Carleton-CTE-Lab/Carleton-Atomic-Force-Microscope/3-D Designs/Active Components/Cantilever Redesigned With 12deg Angle Ver 1.stl

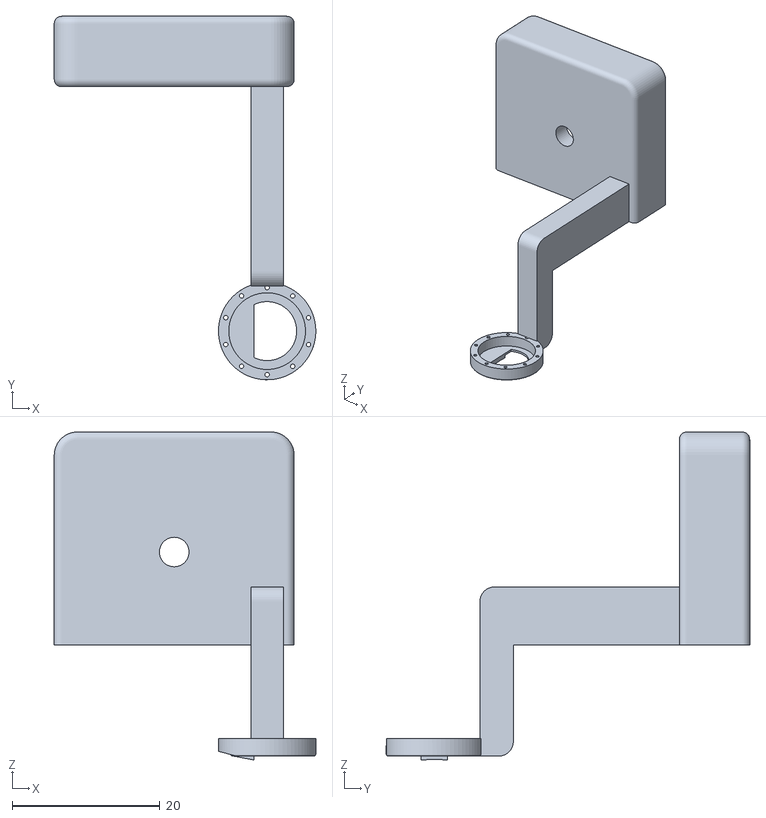
[picture p1: CAD file, 2024-06-18]
3-D Designs/Active Components/Cantilever Redesigned With 12deg Angle Ver 1.stl
35.5 x 49.3 x 44.5
