Carleton-CTE-Lab/Carleton-Atomic-Force-Microscope/3-D Designs/Active Components/Flexi-Holder/Adaption Base.step

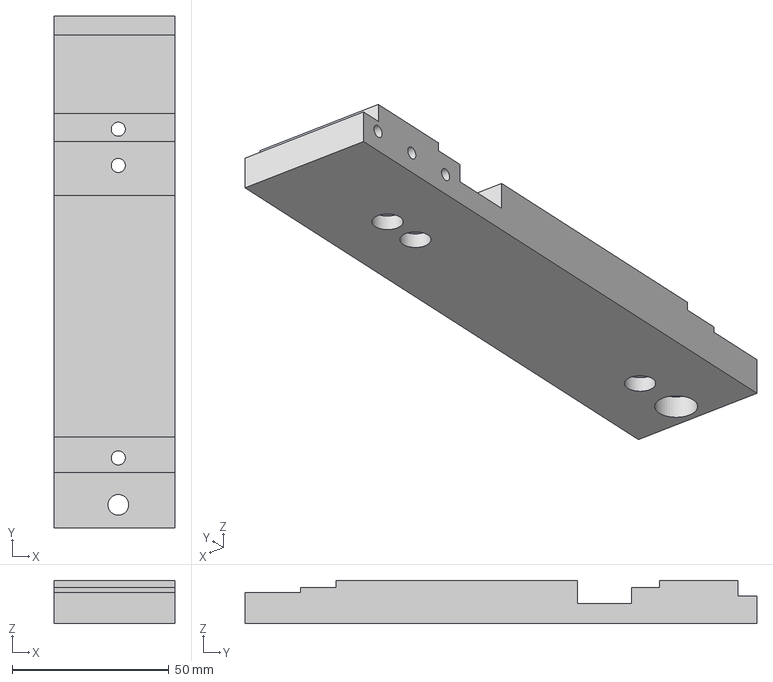
[picture p2: CAD file, 2024-06-18]
3-D Designs/Active Components/Flexi-Holder/Adaption Base.step
38.4 x 163.2 x 13.7 mm
