Carleton-CTE-Lab/Carleton-Atomic-Force-Microscope/3-D Designs/Early Iterations/Cantilever Iterations/Cantilever Holder #8.step

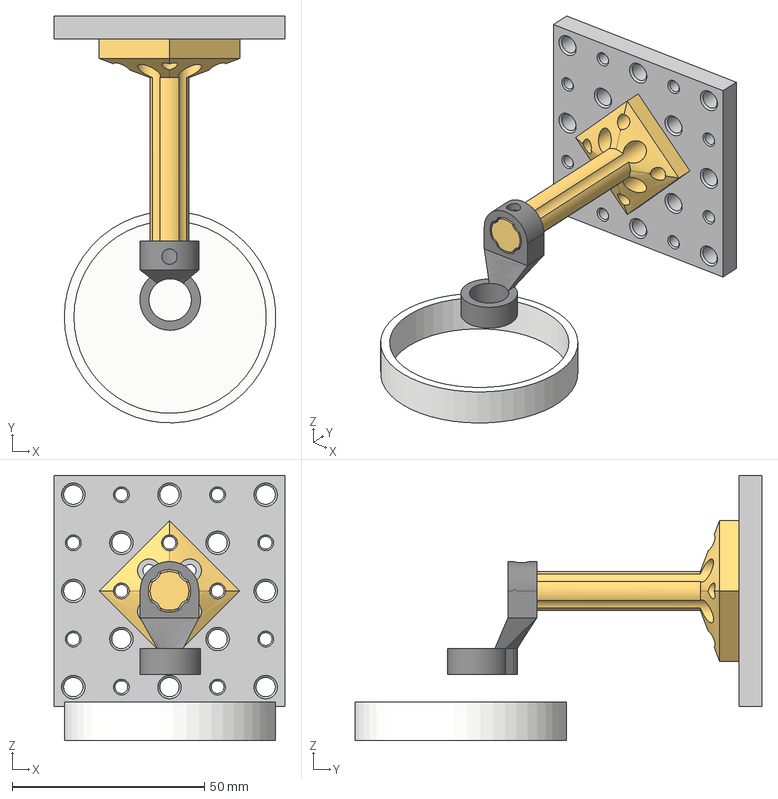
[picture p3: CAD file, 2024-06-24]
3-D Designs/Early Iterations/Cantilever Iterations/Cantilever Holder #8.step
60.0 x 105.7 x 68.9 mm
Petri dish v1
RB13P1_M (Fusion Version)
KB1P_M (Fusion Version)
