Carleton-CTE-Lab/Carleton-Atomic-Force-Microscope/3-D Designs/Early Iterations/Design - Stage Post Clamp - Fixed.step

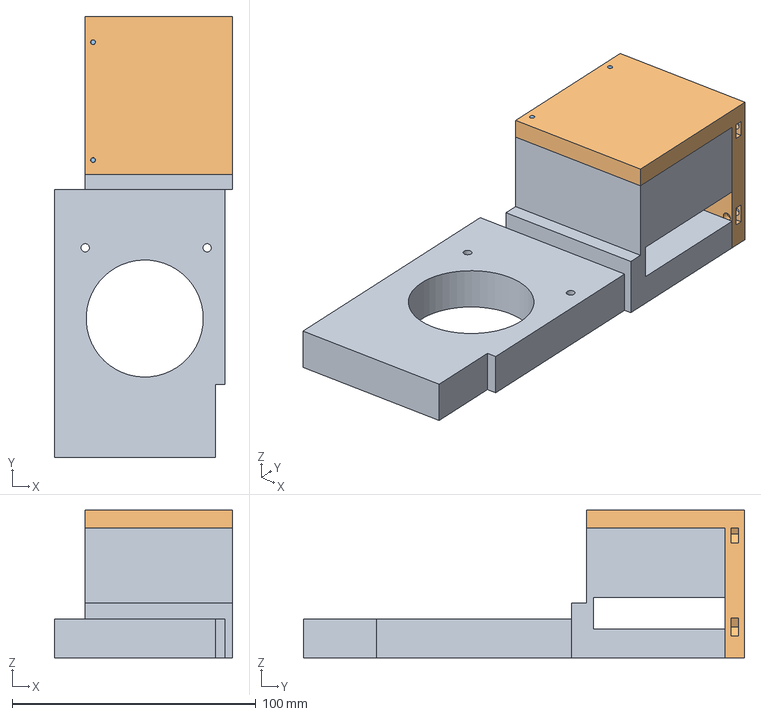
[picture p4: CAD file, 2024-06-24]
3-D Designs/Early Iterations/Design - Stage Post Clamp - Fixed.step
73.0 x 180.9 x 60.6 mm
