Carleton-CTE-Lab/Carleton-Atomic-Force-Microscope/3-D Designs/Early Iterations/Plate Iterations/Plate Renewed Design #16_Plate.step

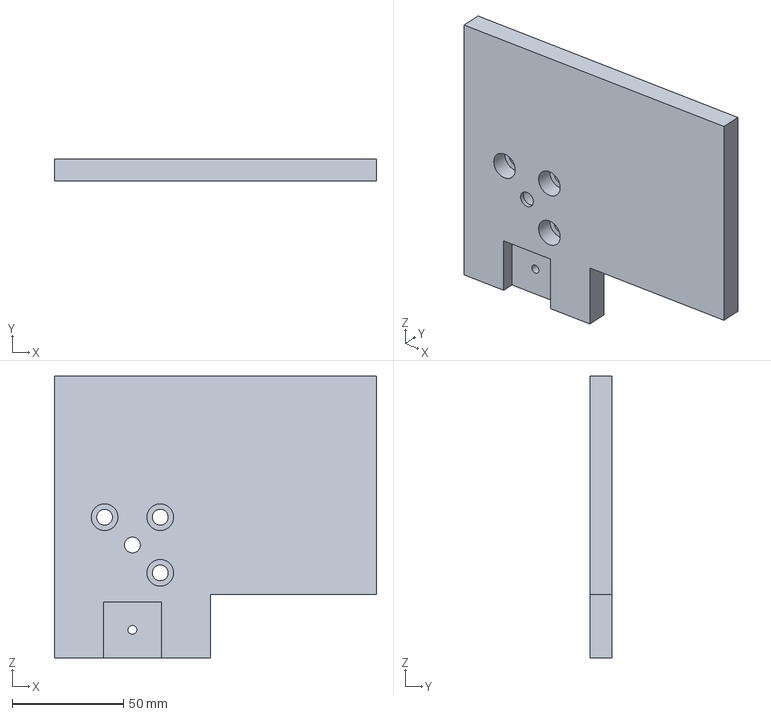
[picture p5: CAD file, 2024-06-24]
3-D Designs/Early Iterations/Plate Iterations/Plate Renewed Design #16_Plate.step
144.6 x 10.0 x 126.6 mm
