Carleton-CTE-Lab/Carleton-Atomic-Force-Microscope/3-D Designs/QOL Accessories/Prism Holder.step

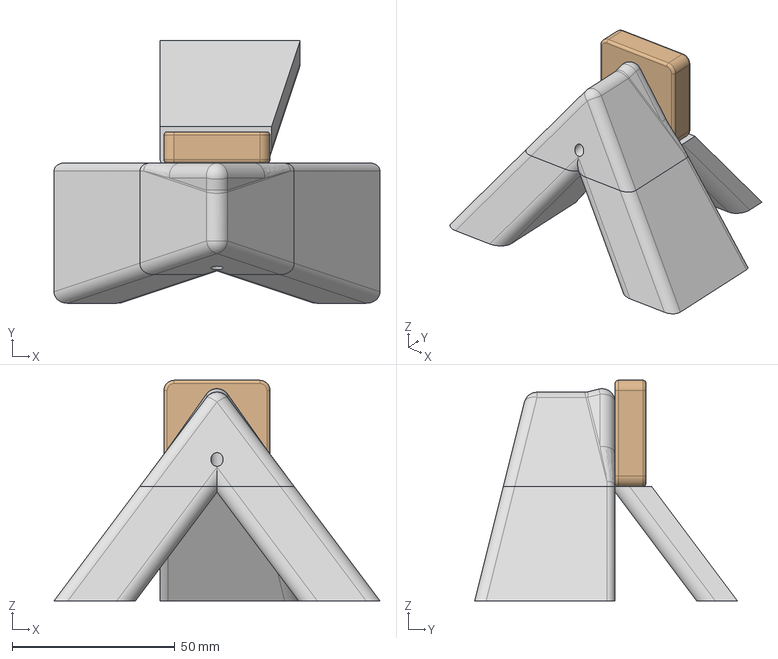
[picture p6: CAD file, 2024-06-18]
3-D Designs/QOL Accessories/Prism Holder.step
100.0 x 80.5 x 67.7 mm
