Carleton-CTE-Lab/Carleton-Atomic-Force-Microscope/3-D Designs/Active Components/Flexi-Holder/Adaption Angle.step

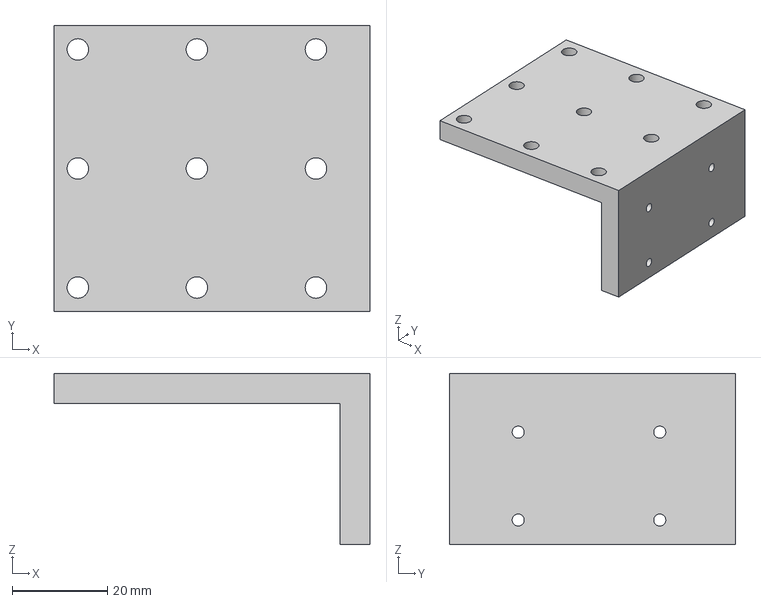
[picture p7: CAD file, 2024-06-18]
3-D Designs/Active Components/Flexi-Holder/Adaption Angle.step
66.4 x 60.0 x 36.0 mm
