Carleton-CTE-Lab/Carleton-Atomic-Force-Microscope/3-D Designs/Early Iterations/Cantilever Iterations/Cxn Base #4 (2nd approach).step

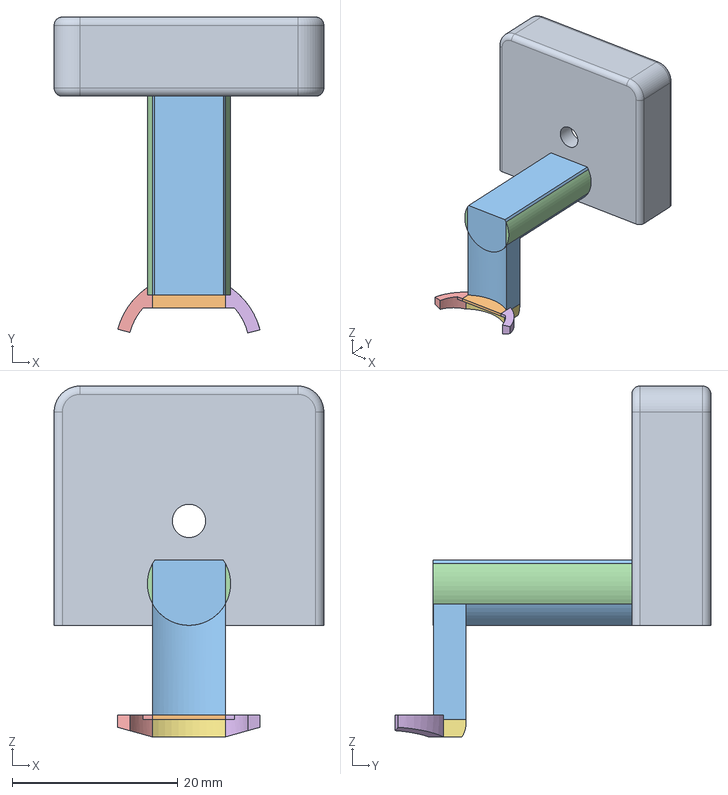
[picture p8: CAD file, 2024-06-24]
3-D Designs/Early Iterations/Cantilever Iterations/Cxn Base #4 (2nd approach).step
32.5 x 38.1 x 42.3 mm
