Carleton-CTE-Lab/Carleton-Atomic-Force-Microscope/3-D Designs/Early Iterations/LED - Driver Adapter.step

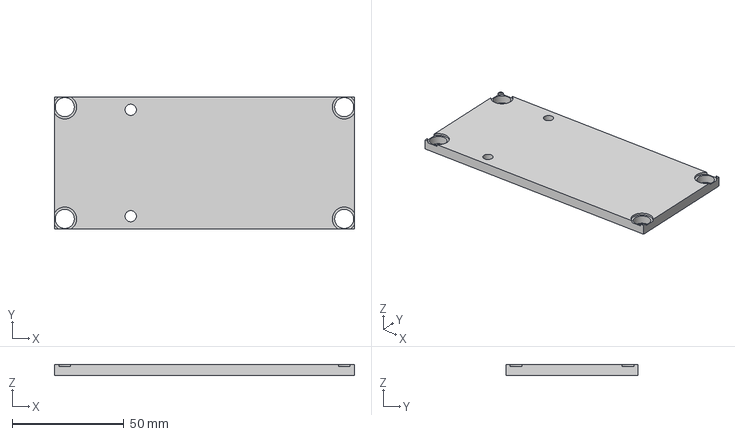
[picture p9: CAD file, 2024-06-24]
3-D Designs/Early Iterations/LED - Driver Adapter.step
134.2 x 59.2 x 5.00 mm
