Carleton-CTE-Lab/Carleton-Atomic-Force-Microscope/3-D Designs/QOL Accessories/AFM Light Fixture.step

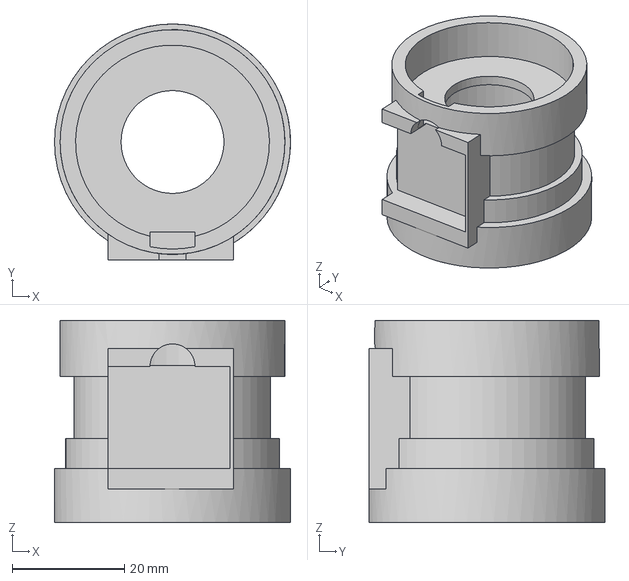
[picture p11: CAD file, 2024-06-18]
3-D Designs/QOL Accessories/AFM Light Fixture.step
42.0 x 42.0 x 36.0 mm
