Carleton-CTE-Lab/Carleton-Atomic-Force-Microscope/3-D Designs/Active Components/Flexi-Holder/Adaption Side.step

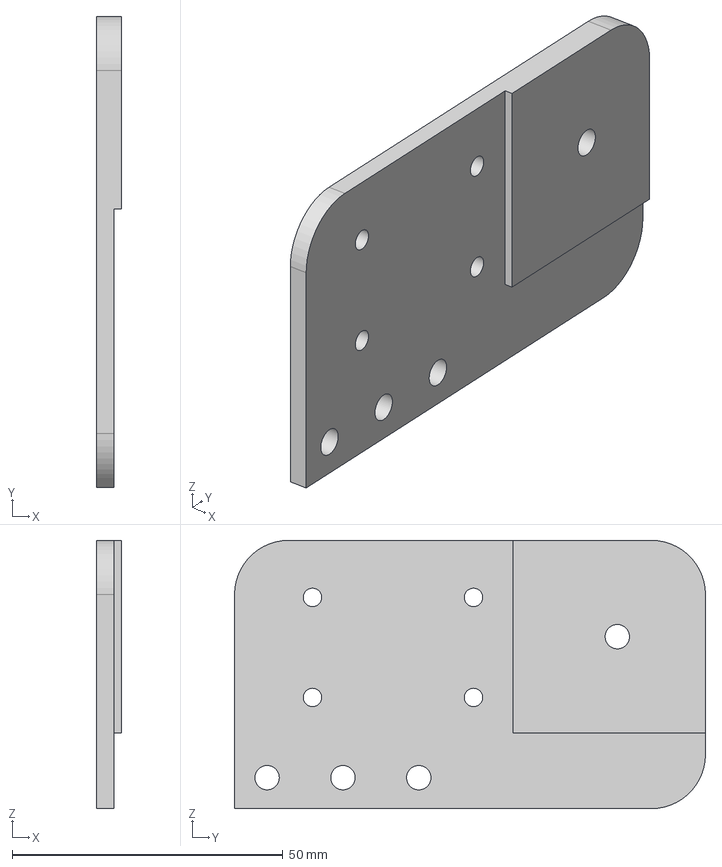
[picture p12: CAD file, 2024-06-18]
3-D Designs/Active Components/Flexi-Holder/Adaption Side.step
4.57 x 87.0 x 49.5 mm
