Carleton-CTE-Lab/Carleton-Atomic-Force-Microscope/3-D Designs/Early Iterations/Cantilever Iterations/Cxn Base #1.step

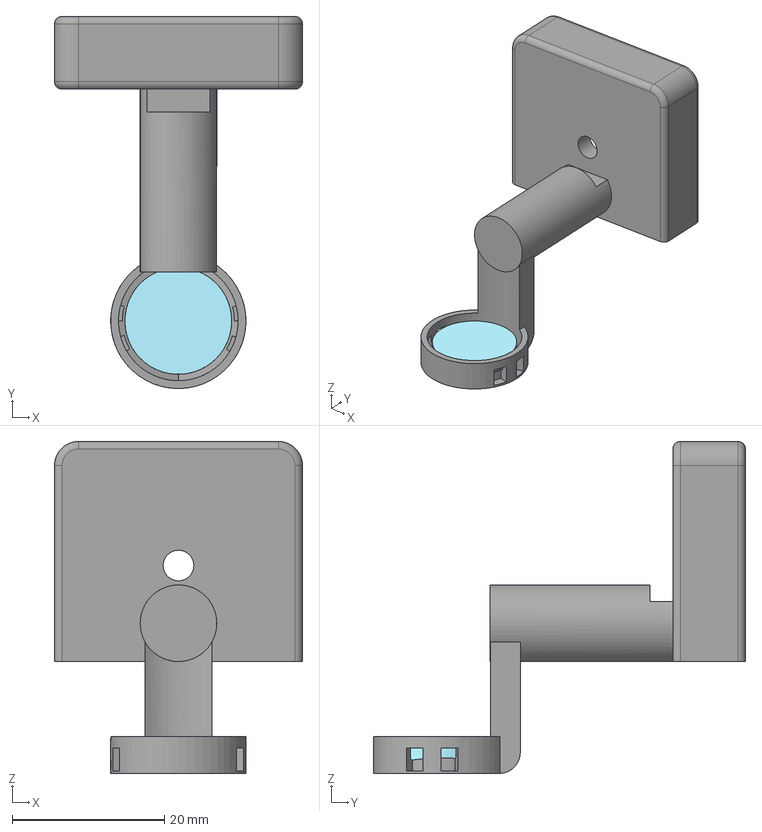
[picture p13: CAD file, 2024-06-24]
3-D Designs/Early Iterations/Cantilever Iterations/Cxn Base #1.step
32.5 x 48.8 x 43.6 mm
