Carleton-CTE-Lab/Carleton-Atomic-Force-Microscope/3-D Designs/Early Iterations/Design - Stage Post Clamp - Adjustable-Removeable.step

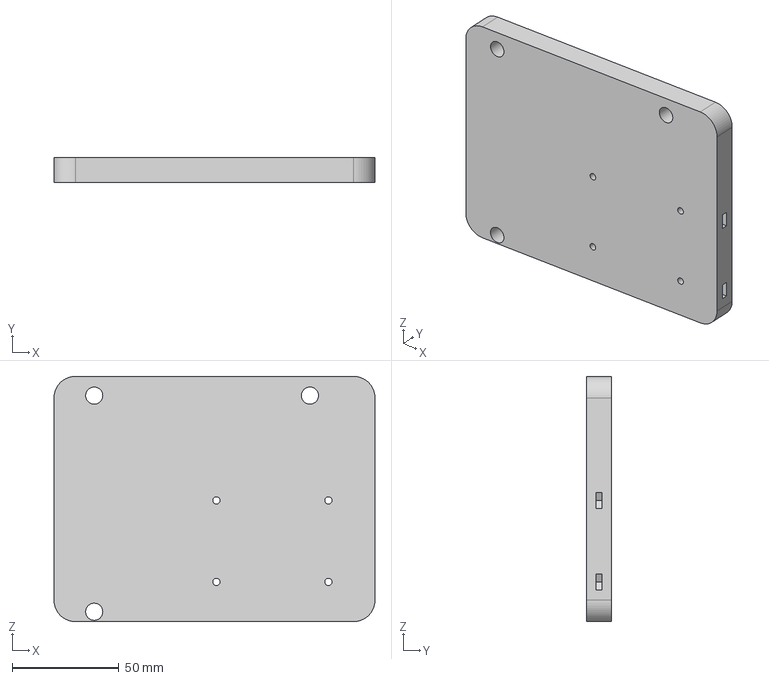
[picture p14: CAD file, 2024-06-24]
3-D Designs/Early Iterations/Design - Stage Post Clamp - Adjustable-Removeable.step
150.0 x 11.6 x 114.6 mm
