Carleton-CTE-Lab/Carleton-Atomic-Force-Microscope/3-D Designs/Early Iterations/Plate Iterations/Plate Renewed Design #8_Plate.step

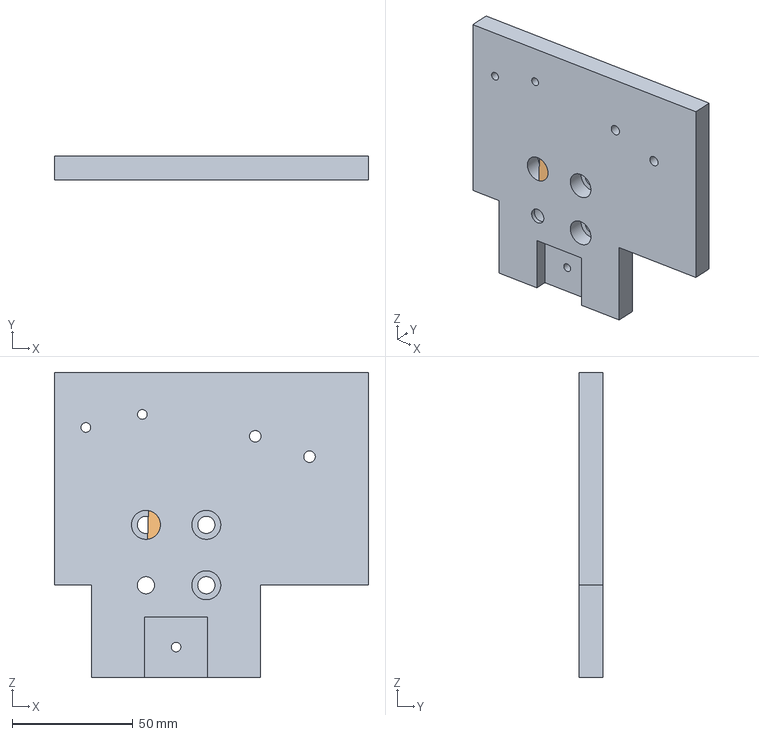
[picture p15: CAD file, 2024-06-24]
3-D Designs/Early Iterations/Plate Iterations/Plate Renewed Design #8_Plate.step
130.0 x 10.0 x 126.3 mm
