Carleton-CTE-Lab/Carleton-Atomic-Force-Microscope/3-D Designs/QOL Accessories/Design - Breadboard Wire Clamp.step

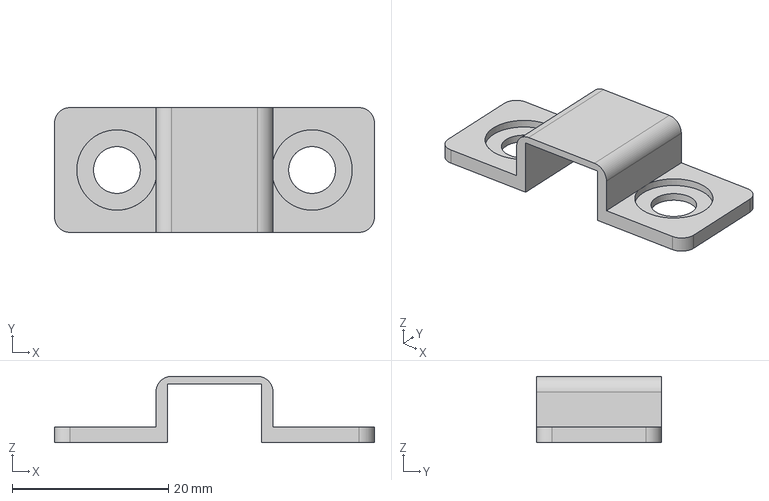
[picture p16: CAD file, 2024-06-18]
3-D Designs/QOL Accessories/Design - Breadboard Wire Clamp.step
41.0 x 16.0 x 8.50 mm
