Carleton-CTE-Lab/Carleton-Atomic-Force-Microscope/3-D Designs/Early Iterations/AFM Flexi Holder.step

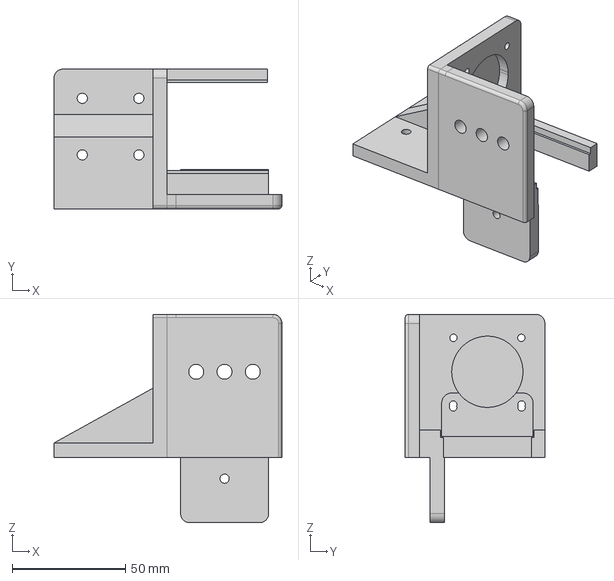
[picture p17: CAD file, 2024-06-24]
3-D Designs/Early Iterations/AFM Flexi Holder.step
100.7 x 61.8 x 92.1 mm
