Carleton-CTE-Lab/Carleton-Atomic-Force-Microscope/3-D Designs/Early Iterations/Cantilever Iterations/Cantilever Holder #12.step

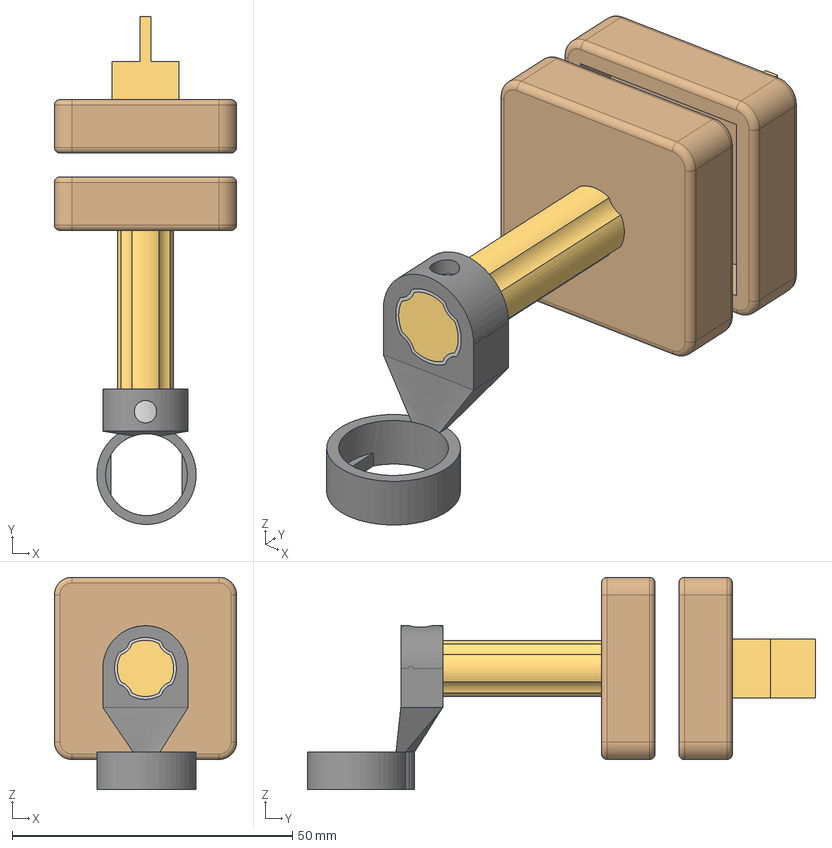
[picture p18: CAD file, 2024-06-24]
3-D Designs/Early Iterations/Cantilever Iterations/Cantilever Holder #12.step
32.5 x 90.7 x 37.9 mm
KB1P_M (Fusion Version) v16
KB25/M(Skin or Cxn Base)_skin(TOP) v1
KB25/M(Skin or Cxn Base)_skin(BOTTOM) v1
