Carleton-CTE-Lab/Carleton-Atomic-Force-Microscope/3-D Designs/QOL Accessories/Design - Breadboard Object Container.step

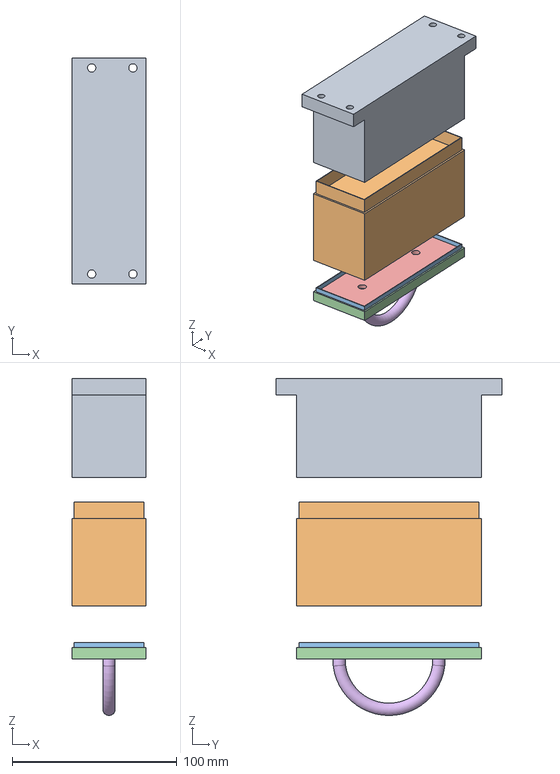
[picture p19: CAD file, 2024-06-18]
3-D Designs/QOL Accessories/Design - Breadboard Object Container.step
45.0 x 137.0 x 204.3 mm
