Carleton-CTE-Lab/Carleton-Atomic-Force-Microscope/3-D Designs/Early Iterations/Cantilever Iterations/Cxn Base Renewed Design #7.step

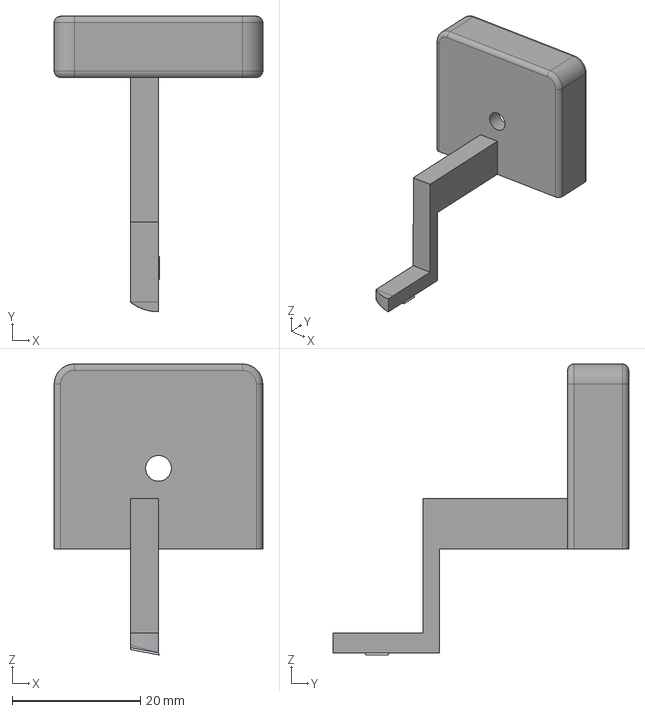
[picture p20: CAD file, 2024-06-24]
3-D Designs/Early Iterations/Cantilever Iterations/Cxn Base Renewed Design #7.step
32.5 x 46.1 x 45.4 mm
Prism (Half) v1(Mirror)
PartCantilever v1
