Carleton-CTE-Lab/Carleton-Atomic-Force-Microscope/3-D Designs/Early Iterations/Cantilever Iterations/Cxn Base Renewed Design #11.step

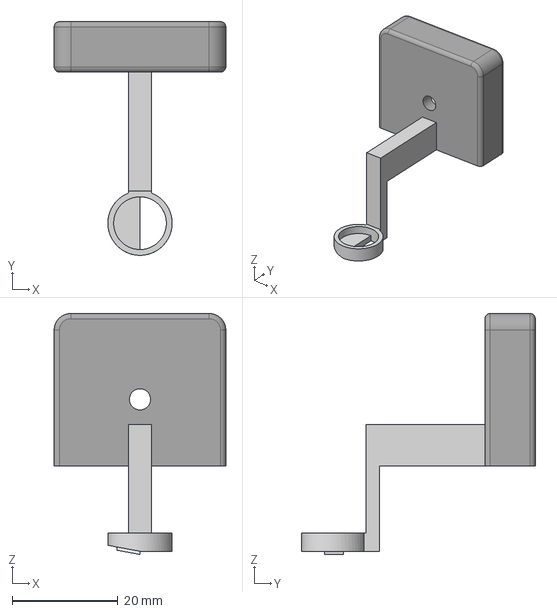
[picture p21: CAD file, 2024-06-24]
3-D Designs/Early Iterations/Cantilever Iterations/Cxn Base Renewed Design #11.step
32.5 x 44.3 x 45.7 mm
