Carleton-CTE-Lab/Carleton-Atomic-Force-Microscope/(list of files, cad)

Other CAD files:
3-D Designs/Active Components/Cantilever Redesigned With 12deg Angle V1.step
3-D Designs/Active Components/Flexi-Holder/Adaption Angle.stl
3-D Designs/Active Components/Flexi-Holder/Adaption Base.stl
3-D Designs/Active Components/Flexi-Holder/Adaption Side.stl
3-D Designs/Early Iterations/AFM Flexi Holder.stl
3-D Designs/Early Iterations/Cantilever Iterations/Cantilever Holder #12.stl
3-D Designs/Early Iterations/Cantilever Iterations/Cantilever Holder #8.stl
3-D Designs/Early Iterations/Cantilever Iterations/Cxn Base #1.stl
3-D Designs/Early Iterations/Cantilever Iterations/Cxn Base #4 (2nd approach).stl
3-D Designs/Early Iterations/Cantilever Iterations/Cxn Base Renewed Design #11.stl
3-D Designs/Early Iterations/Cantilever Iterations/Cxn Base Renewed Design #7.stl
3-D Designs/Early Iterations/Design - Stage Post Clamp - Adjustable-Removeable.stl
3-D Designs/Early Iterations/Design - Stage Post Clamp - Fixed.stl
3-D Designs/Early Iterations/LED - Driver Adapter.stl
3-D Designs/Early Iterations/Plate Iterations/Plate Renewed Design #15_Plate.stl
3-D Designs/Early Iterations/Plate Iterations/Plate Renewed Design #16_Plate.stl
3-D Designs/Early Iterations/Plate Iterations/Plate Renewed Design #8_Plate.stl
3-D Designs/Early Iterations/Version 1/Adapter Concept #2 (AP90 M &PartM0093).step
3-D Designs/Early Iterations/Version 1/Adapter Concept #2 (AP90 M &PartM0093).stl
3-D Designs/Early Iterations/Version 1/Adapter Concept #3 (AP90 M &PartM0093).step
3-D Designs/Early Iterations/Version 1/Adapter Concept #3 (AP90 M &PartM0093).stl
3-D Designs/Early Iterations/Version 1/Adapter Concept #3 (AP90 M &PartM0093)_Component5.step
3-D Designs/Early Iterations/Version 1/Adapter Concept #3 (AP90 M &PartM0093)_Component5.stl
3-D Designs/Early Iterations/Version 1/Adapter Concept #4 (AP90 M &PartM0093).step
3-D Designs/Early Iterations/Version 1/Adapter Concept #4 (AP90 M &PartM0093).stl
3-D Designs/Early Iterations/Version 1/Adapter Concept #4_Component.step
3-D Designs/Early Iterations/Version 1/Adapter Concept #4_Component.stl
3-D Designs/Early Iterations/Version 1/Adapter Concept (AP90_M &PartM0093).step
3-D Designs/Early Iterations/Version 1/Adapter Concept (AP90_M &PartM0093).stl
3-D Designs/Early Iterations/Version 1/Adapter Plate (Feb iteration).step
3-D Designs/Early Iterations/Version 1/Adapter Plate (Feb iteration).stl
3-D Designs/Early Iterations/Version 1/Plate (Background Screen Modification)_MSC2 Modified.step
3-D Designs/Early Iterations/Version 1/Plate (Background Screen Modification)_MSC2 Modified.stl
3-D Designs/Early Iterations/Version 2/Optics Adapter Prototype #1 (RB13P1M & Optics).step
3-D Designs/Early Iterations/Version 2/Optics Adapter Prototype #1 (RB13P1M & Optics).stl
3-D Designs/Early Iterations/Version 2/Optics Adapter Prototype #2 (RB13P1M & Optics).step
3-D Designs/Early Iterations/Version 2/Optics Adapter Prototype #2 (RB13P1M & Optics).stl
3-D Designs/Early Iterations/Version 2/Optics Adapter Prototype #3 (RB13P1M & Optics).step
3-D Designs/Early Iterations/Version 2/Optics Adapter Prototype #3 (RB13P1M & Optics).stl
3-D Designs/Early Iterations/Version 2/Optics Adapter Prototype #4 (RB13P1M & Optics).step
3-D Designs/Early Iterations/Version 2/Optics Adapter Prototype #4 (RB13P1M & Optics).stl
3-D Designs/Early Iterations/Version 2/Optics Adapter Prototype #5 (RB13P1M & Optics).step
3-D Designs/Early Iterations/Version 2/Optics Adapter Prototype #5 (RB13P1M & Optics).stl
3-D Designs/Early Iterations/Version 2/Optics Adapter Prototype #6 (RB13P1M & Optics).step
3-D Designs/Early Iterations/Version 2/Optics Adapter Prototype #6 (RB13P1M & Optics).stl
3-D Designs/Early Iterations/Version 2/Optics Adapter Prototype #7 (RB13P1M & Optics).step
3-D Designs/Early Iterations/Version 2/Optics Adapter Prototype #7 (RB13P1M & Optics).stl
3-D Designs/Early Iterations/Version 2/Plate #1_Component6.step
3-D Designs/Early Iterations/Version 2/Plate #1_Component6.stl
3-D Designs/Early Iterations/Version 2/Plate #2_.step
3-D Designs/Early Iterations/Version 2/Plate #2_.stl
3-D Designs/Early Iterations/Version 2/Plate #2_Component6.step
3-D Designs/Early Iterations/Version 2/Plate #2_Component6.stl
3-D Designs/Early Iterations/Version 2/Plate #3_Component6.step
3-D Designs/Early Iterations/Version 2/Plate #3_Component6.stl
3-D Designs/Early Iterations/Version 2/Plate Jigsaw Piece.step
3-D Designs/Early Iterations/Version 2/Plate Jigsaw Piece.stl
3-D Designs/QOL Accessories/AFM Light Fixture.stl
3-D Designs/QOL Accessories/Design - Breadboard Object Container.stl
3-D Designs/QOL Accessories/Design - Breadboard Wire Clamp.stl
3-D Designs/QOL Accessories/Prism Holder.stl
3-D Designs/Thorlabs Components/AD11F-Step.step
3-D Designs/Thorlabs Components/AM16C_M.step
3-D Designs/Thorlabs Components/AM16C_M.stl
3-D Designs/Thorlabs Components/AMA011_M (Fusion Version).step
3-D Designs/Thorlabs Components/AMA011_M (Fusion Version).stl
3-D Designs/Thorlabs Components/AP90_M (Modified Version).step
3-D Designs/Thorlabs Components/AP90_M (Modified Version).stl
3-D Designs/Thorlabs Components/AP90_M Bracket.step
3-D Designs/Thorlabs Components/AP90_M Bracket.stl
3-D Designs/Thorlabs Components/Adafruit neopixel ring.step
3-D Designs/Thorlabs Components/Adafruit neopixel ring.stl
3-D Designs/Thorlabs Components/ArduinoMega_IGES.stl
3-D Designs/Thorlabs Components/Breadboard (B4560A).step
3-D Designs/Thorlabs Components/CCM1-4ER_M-Step.step
3-D Designs/Thorlabs Components/CCM1-4ER_M-Step.stl
3-D Designs/Thorlabs Components/CCM1-P01_M-Step.step
3-D Designs/Thorlabs Components/CCM1-P01_M-Step.stl
3-D Designs/Thorlabs Components/CFH2R_M-Step.step
3-D Designs/Thorlabs Components/CFH2R_M-Step.stl
3-D Designs/Thorlabs Components/CFS1-Step.step
3-D Designs/Thorlabs Components/CFS1_M-Step.step
3-D Designs/Thorlabs Components/CFS1_M-Step.stl
3-D Designs/Thorlabs Components/CH1A.step
3-D Designs/Thorlabs Components/CH1A.stl
3-D Designs/Thorlabs Components/CL6-Step.step
3-D Designs/Thorlabs Components/CSS2001-Step.step
3-D Designs/Thorlabs Components/Cantilever Holder (KB1X1).step
3-D Designs/Thorlabs Components/Cantilever Holder (KB1X1).stl
3-D Designs/Thorlabs Components/Coupler - Large (SM1T20).step
3-D Designs/Thorlabs Components/Coupler - Large (SM1T20).stl
3-D Designs/Thorlabs Components/Coupler - Miniature(SM1T2).step
3-D Designs/Thorlabs Components/Coupler - Miniature(SM1T2).stl
3-D Designs/Thorlabs Components/Cube - Connector (C4W-CC).step
3-D Designs/Thorlabs Components/Cube - Connector (C4W-CC).stl
3-D Designs/Thorlabs Components/Cube - Kinematics (DFM1B_M).step
3-D Designs/Thorlabs Components/Cube - Kinematics (DFM1B_M).stl
3-D Designs/Thorlabs Components/Cube - Mirror(CCM1-P01_M).step
3-D Designs/Thorlabs Components/Cube - Mirror(CCM1-P01_M).stl
3-D Designs/Thorlabs Components/Cube Controller (KCH601).stl
3-D Designs/Thorlabs Components/DCP1-Step.step
3-D Designs/Thorlabs Components/DCP1-Step.stl
3-D Designs/Thorlabs Components/DCP1A-Step.step
3-D Designs/Thorlabs Components/DCP1A-Step.stl
3-D Designs/Thorlabs Components/DFM1B_M-Step.step
3-D Designs/Thorlabs Components/DFM1B_M-Step.stl
3-D Designs/Thorlabs Components/DFM1C-Step.step
3-D Designs/Thorlabs Components/DFM1C-Step.stl
3-D Designs/Thorlabs Components/DG05-1500-Step.step
3-D Designs/Thorlabs Components/DG05-1500-Step.stl
3-D Designs/Thorlabs Components/F230FC-B.step
3-D Designs/Thorlabs Components/F230FC-B.stl
3-D Designs/Thorlabs Components/F280FC-B-Step.step
3-D Designs/Thorlabs Components/FMP1_M-Step.step
3-D Designs/Thorlabs Components/FMP1_M-Step.stl
3-D Designs/Thorlabs Components/FMP1_M.step
3-D Designs/Thorlabs Components/FMP1_M.stl
3-D Designs/Thorlabs Components/Filter - Dichroic Mirror(MD498).step
3-D Designs/Thorlabs Components/Filter - Dichroic Mirror(MD498).stl
3-D Designs/Thorlabs Components/Filter - Emission (MF510-42).step
3-D Designs/Thorlabs Components/Filter - Emission (MF510-42).stl
3-D Designs/Thorlabs Components/Filter - Emission(MF630-69).step
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
