Carleton-CTE-Lab/Carleton-Atomic-Force-Microscope/3-D Designs/Drawing Files/A Hanging AFM Configuration Expanded Drawing v13.pdf

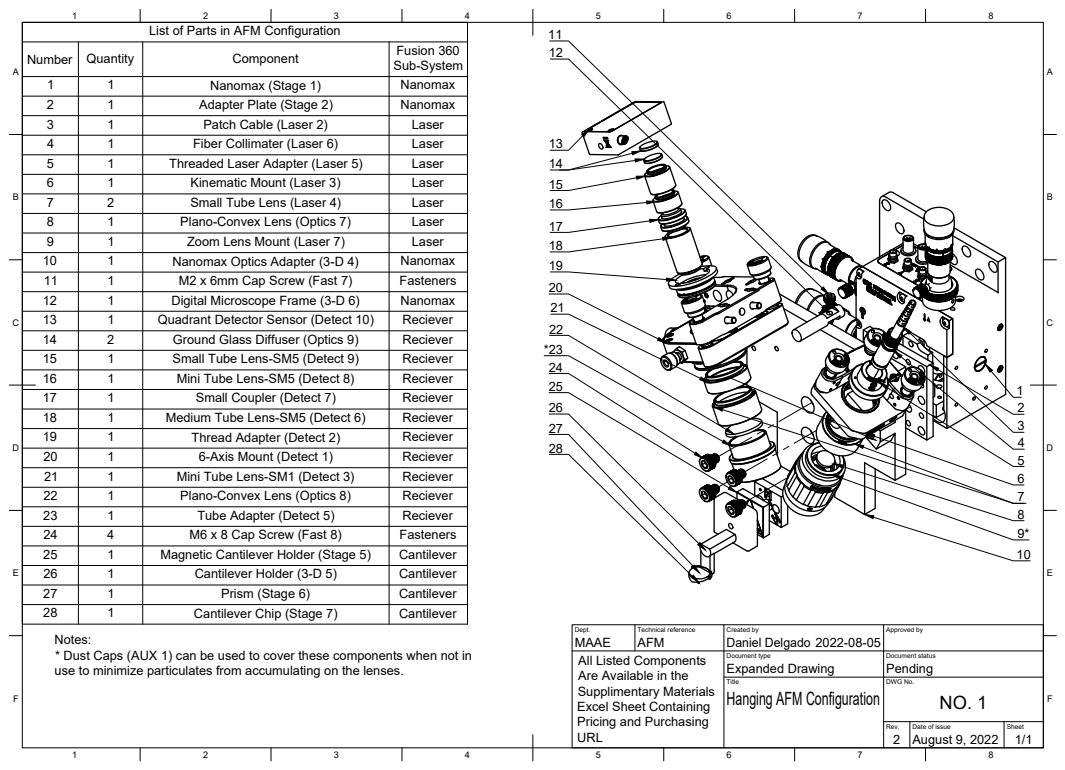
[picture p23: page 1]
Dept.; Technical reference; Created by; Approved by; Document type; Document status; Title; DWG No.; Rev.; Date of issue; Sheet; 2 August 9, 2022; Expanded Drawing; Pending; Hanging AFM Configuration; MAAE; AFM; Daniel Delgado; Number Quantity; Component; Fusion 360; Nanomax (Stage 1); Nanomax; Adapter Plate (Stage 2); Patch Cable (Laser 2); Laser; Fiber Collimater (Laser 6); Threaded Laser Adapter (Laser 5); Kinematic Mount (Laser 3); Small Tube Lens (Laser 4); Plano-Convex Lens (Optics 7)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

List of Parts in AFM Configuration

All Listed Components
Are Available in the
Supplimentary Materials
Excel Sheet Containing
Pricing and Purchasing
URL

Notes:
* Dust Caps (AUX 1) can be used to cover these components when not in
use to minimize particulates from accumulating on the lenses.
