Carleton-CTE-Lab/Carleton-Atomic-Force-Microscope/3-D Designs/Active Components/Flexi-Holder/Adaption Angle Drawing.pdf

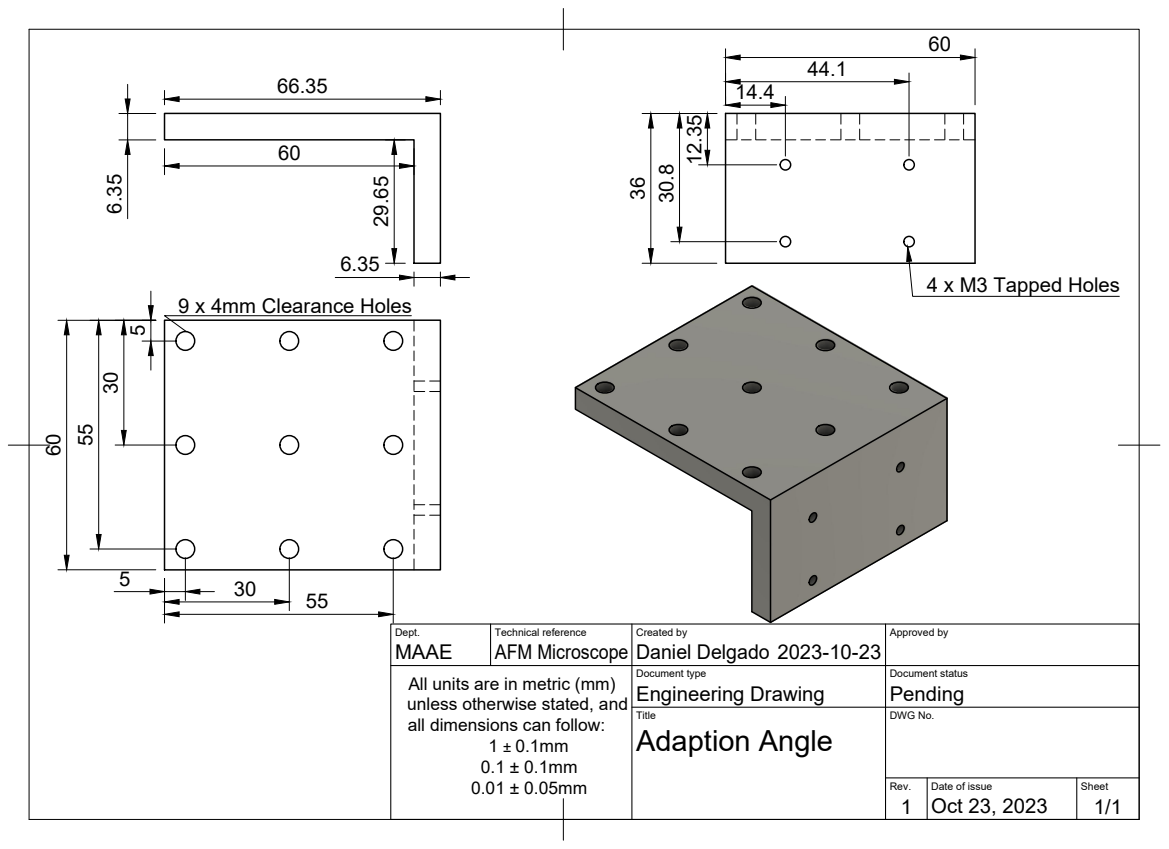
[picture p26: page 1]
9 x 4mm Clearance Holes 29.65; 4 x M3 Tapped Holes

Dept. MAAE | Technical reference AFM Microscope | Created by Daniel Delgado 2023-10-23 | Approved by

All units are in metric (mm) unless otherwise stated, and all dimensions can follow: 1 ± 0.1mm 0.1 ± 0.1mm | | Document type Engineering Drawing | Document status Pending

Title Adaption Angle | DWG No.

Rev. 1 | Date of issue Oct 23, 2023 | Sheet 1/1
