Carleton-CTE-Lab/Carleton-Atomic-Force-Microscope/3-D Designs/Active Components/Flexi-Holder/Adaption Base Drawing.pdf

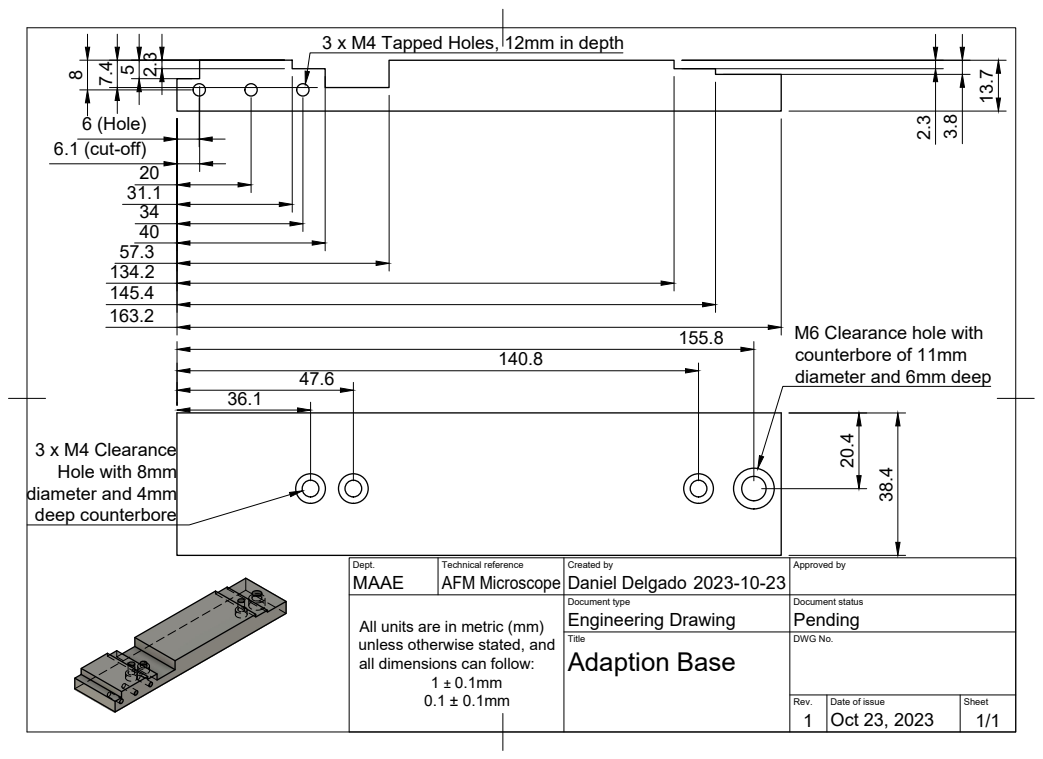
[picture p27: page 1]
MAAE; AFM Microscope; Daniel Delgado; 6 (Hole) 6.1 (cut-off); 3 x M4 Clearance Hole with 8mm diameter and 4mm deep counterbore

3 x M4 Tapped Holes, 12mm in depth

M6 Clearance hole with
counterbore of 11mm
diameter and 6mm deep

Dept. | Technical reference | Created by 2023-10-23 | Approved by

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

Title Adaption Base | DWG No.

Rev. 1 | Date of issue Oct 23, 2023 | Sheet 1/1
