Carleton-CTE-Lab/Carleton-Atomic-Force-Microscope/3-D Designs/Active Components/Flexi-Holder/Adaption Side Drawing.pdf

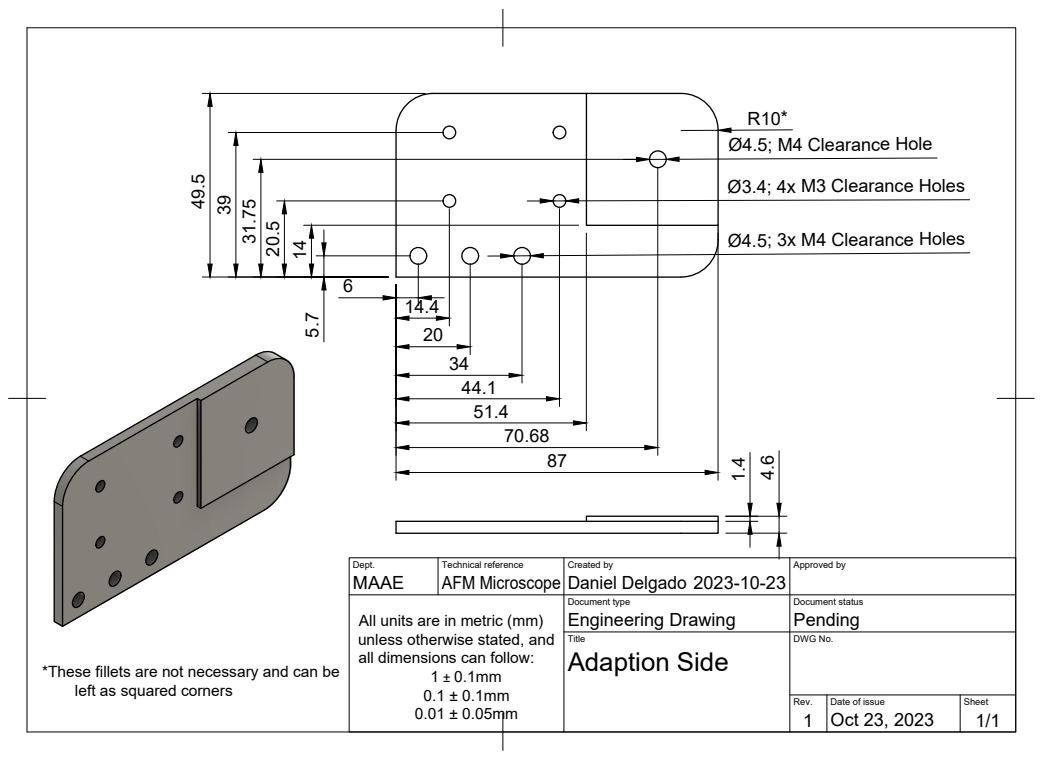
[picture p28: page 1]
Ø4.5; 3x M4 Clearance Holes; Ø3.4; 4x M3 Clearance Holes; Ø4.5; M4 Clearance Hole

Dept. MAAE | Technical reference AFM Microscope | Created by Daniel Delgado 2023-10-23 | Approved by

All units are in metric (mm) unless otherwise stated, and all dimensions can follow: 1 ± 0.1mm 0.1 ± 0.1mm 0.01 ± 0.05mm | | Document type Engineering Drawing | Document status Pending

Title Adaption Side | DWG No.

*These fillets are not necessary and can be
left as squared corners

Rev. 1 | Date of issue Oct 23, 2023 | Sheet 1/1
