Carleton-CTE-Lab/Carleton-Atomic-Force-Microscope/3-D Designs/Drawing Files/Abstract AFM-Flexi Scope Drawing.pdf

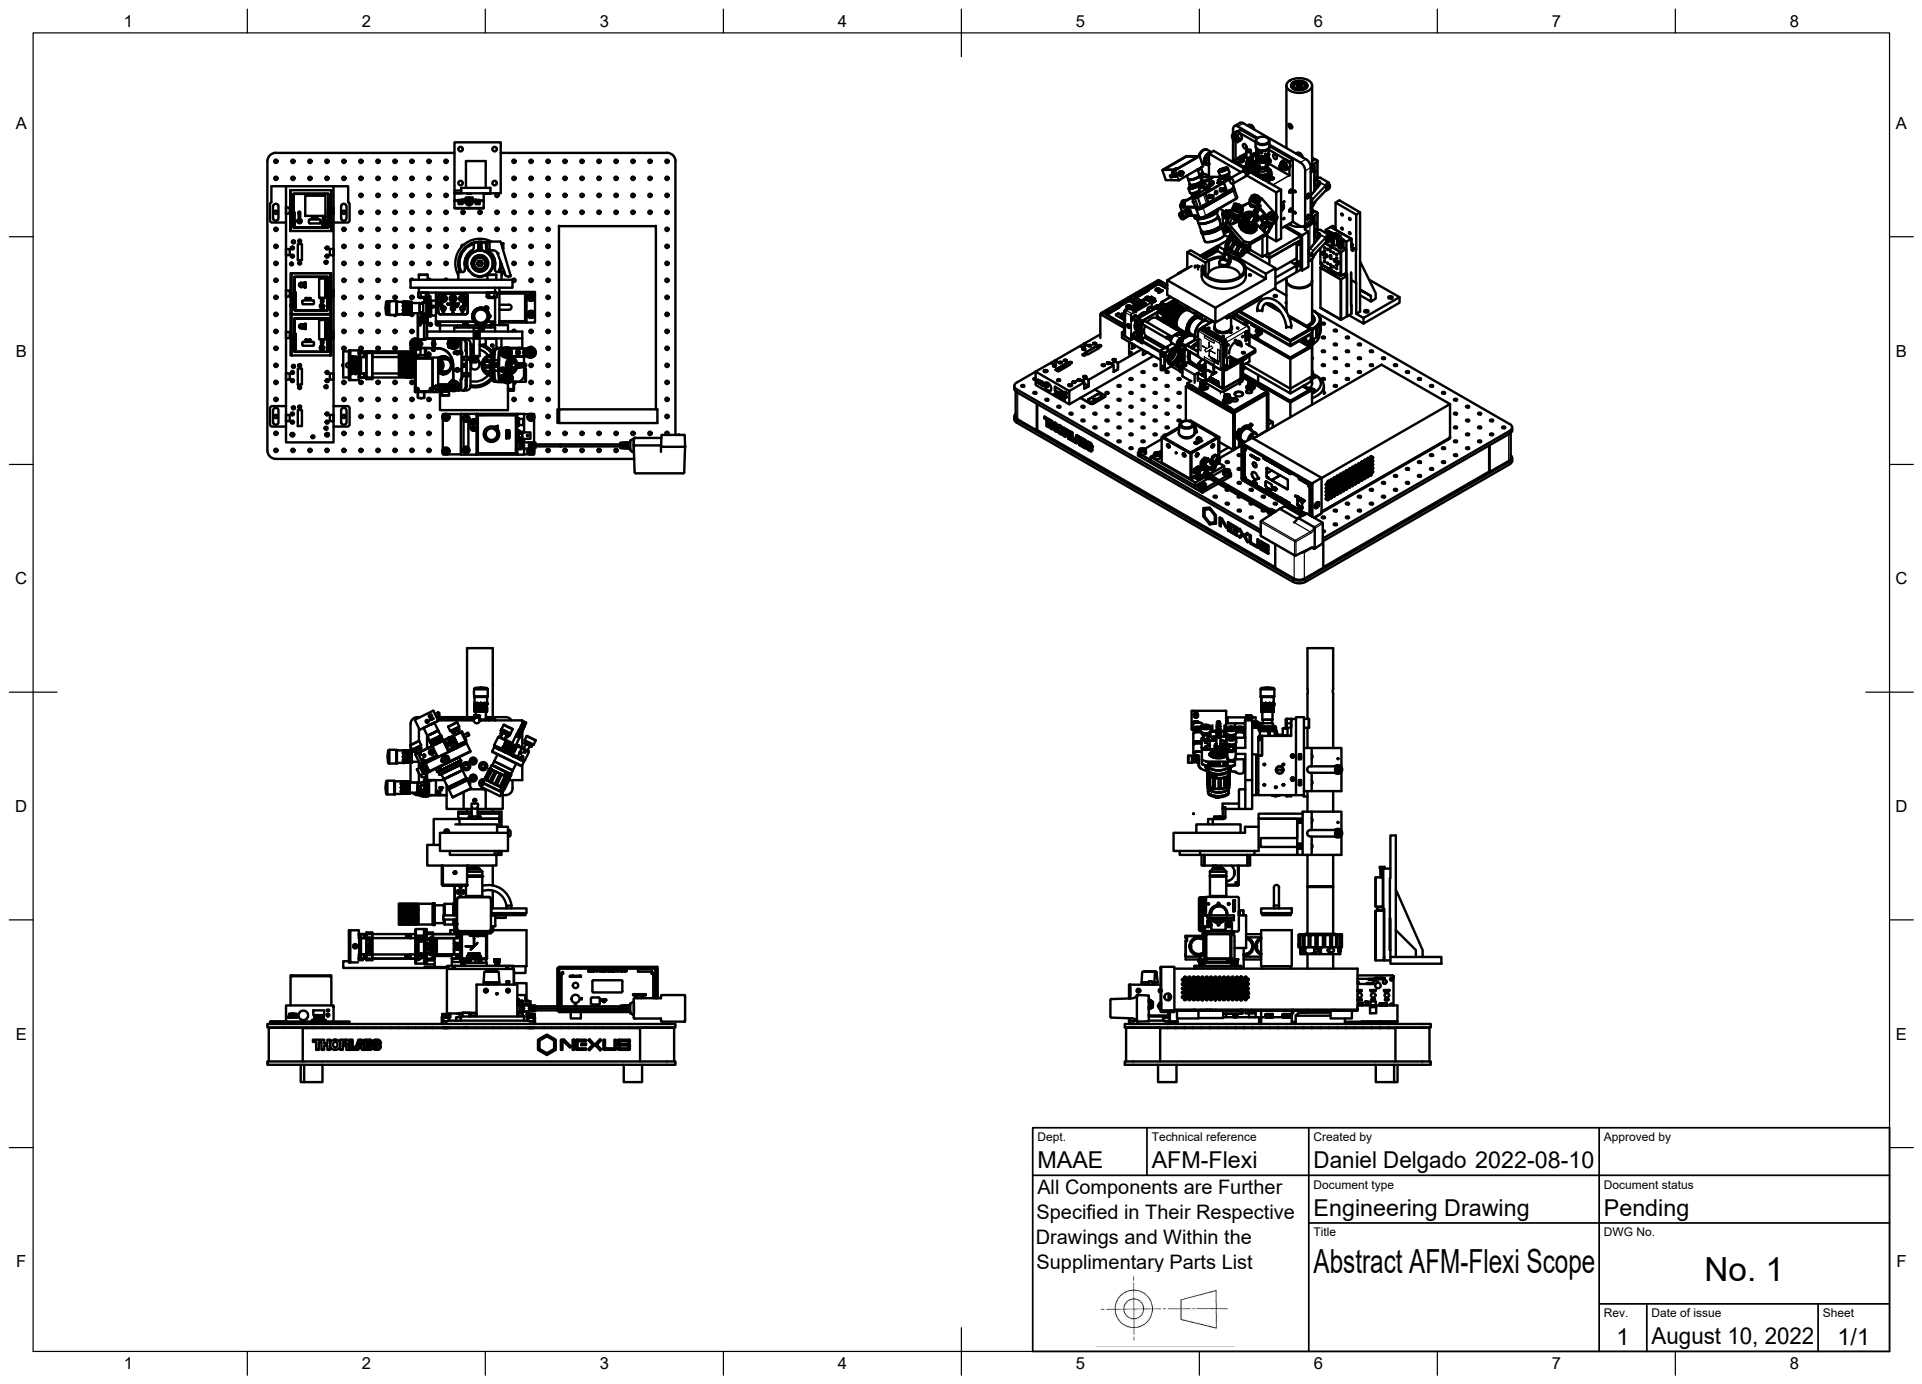
[picture p29: page 1]
Dept.; Technical reference; Created by; Approved by; Document type; Document status; Title; DWG No.; Rev.; Date of issue; Sheet; 1 August 10, 2022; Engineering Drawing; Pending; Abstract AFM-Flexi Scope; MAAE; AFM-Flexi; Daniel Delgado

All Components are Further
Specified in Their Respective
Drawings and Within the
Supplimentary Parts List
