Carleton-CTE-Lab/Carleton-Atomic-Force-Microscope/3-D Designs/Drawing Files/Abstract AFM-Flexi Scope Exploaded Drawing.pdf

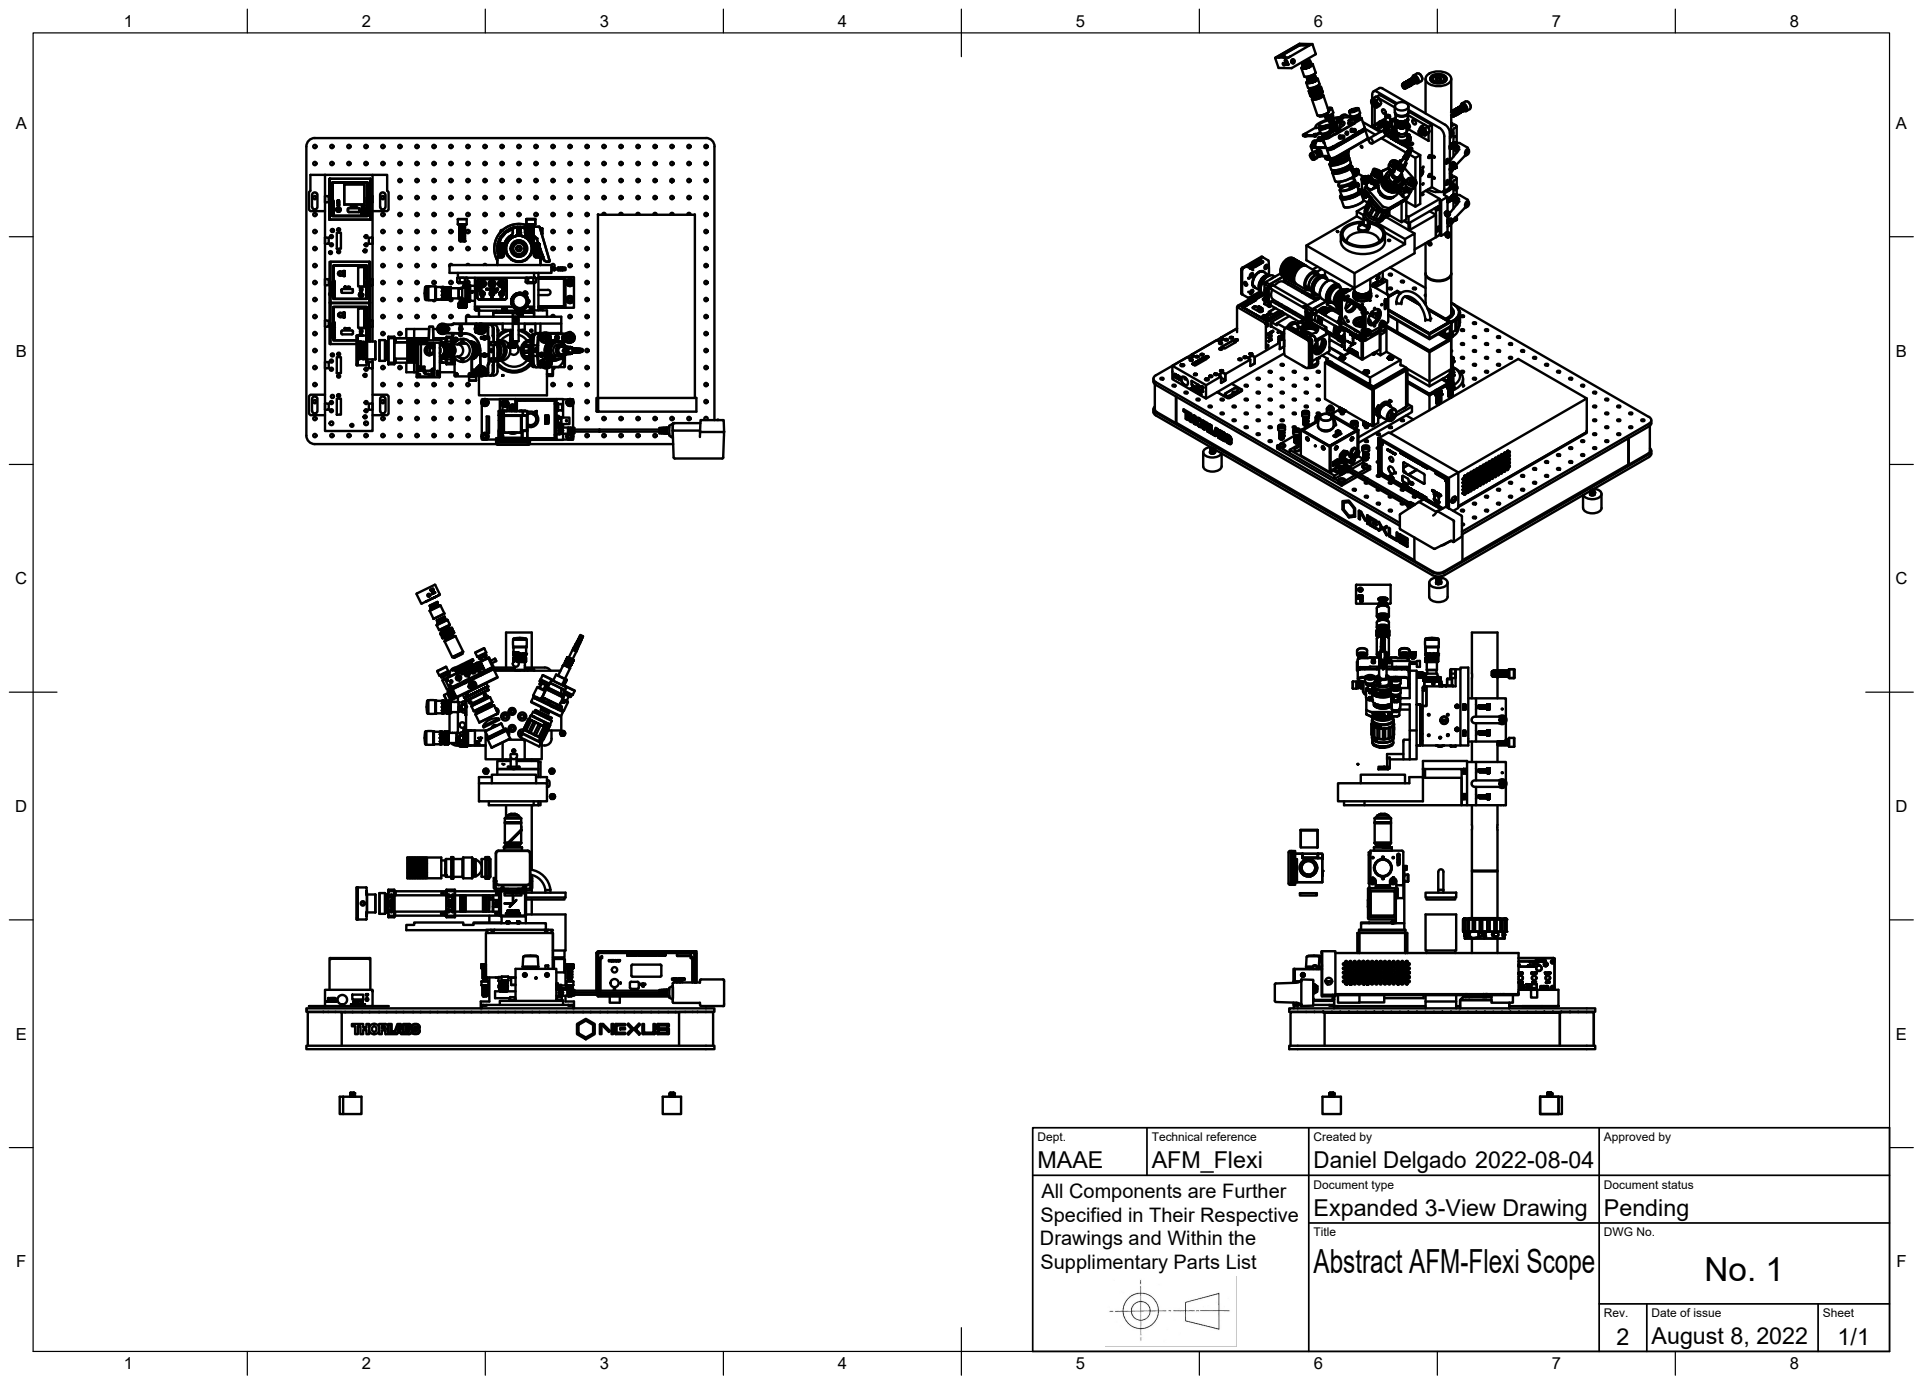
[picture p30: page 1]
Dept.; Technical reference; Created by; Approved by; Document type; Document status; Title; DWG No.; Rev.; Date of issue; Sheet; 2 August 8, 2022; Abstract AFM-Flexi Scope; MAAE; AFM_Flexi; Daniel Delgado

All Components are Further
Specified in Their Respective
Drawings and Within the
Supplimentary Parts List

Expanded 3-View Drawing Pending
